VladVeliciu/Automatic-Greenhouse-System/Bill of Materials.PDF

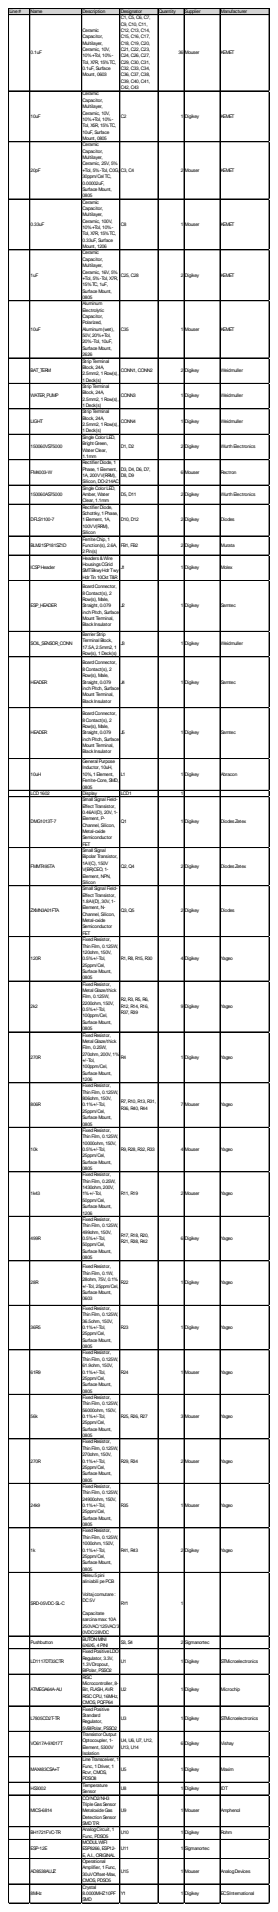
[picture p1: page 1]

10uF | Ceramic Capacitor, Multilayer, Ceramic, 10V, 10%+Tol, 10%-Tol, X5R, 15%TC, 10uF, Surface Mount, 0805 | C2 | 1 Digikey | KEMET

20pF | Ceramic Capacitor, Multilayer, Ceramic, 25V, 5% +Tol, 5%-Tol, C0G, 30ppm/Cel TC, 0.00002uF, Surface Mount, 0805 | C3, C4 | 2 Mouser | KEMET

0.33uF | Ceramic Capacitor, Multilayer, Ceramic, 100V, 10%+Tol, 10%-Tol, X7R, 15%TC, 0.33uF, Surface Mount, 1206 | C8 | 1 Mouser | KEMET

1uF | Ceramic Capacitor, Multilayer, Ceramic, 16V, 5% +Tol, 5%-Tol, X7R, 15%TC, 1uF, Surface Mount, 0805 | C25, C28 | 2 Digikey | KEMET

10uF | Aluminum Electrolytic Capacitor, Polarized, Aluminum(wet), 50V, 20%+Tol, 20%-Tol, 10uF, Surface Mount, 2626 | C35 | 1 Mouser | KEMET

BAT_TERM | Strip Terminal Block, 24A, 2.5mm2, 1Row(s), 1Deck(s) | CONN1, CONN2 | 2 Digikey | Weidmuller

WATER_PUMP | Strip Terminal Block, 24A, 2.5mm2, 1Row(s), 1Deck(s) | CONN3 | 1 Digikey | Weidmuller

LIGHT | Strip Terminal Block, 24A, 2.5mm2, 1Row(s), 1Deck(s) | CONN4 | 1 Digikey | Weidmuller

150060VS75000 | Single Color LED, Bright Green, Water Clear, 1.1mm | D1, D2 | 2 Digikey | WurthElectronics

FM4003-W | Rectifier Diode, 1 Phase, 1Element, 1A, 200VV(RRM), Silicon, DO-214AC | D3, D4, D6, D7, D8, D9 | 6 Mouser | Rectron

150060AS75000 | Single Color LED, Amber, Water Clear, 1.1mm | D5, D11 | 2 Digikey | WurthElectronics

DFLS1100-7 | Rectifier Diode, Schottky, 1Phase, 1Element, 1A, 100VV(RRM), Silicon | D10, D12 | 2 Digikey | Diodes

BLM21SP181SZ1D | FerriteChip, 1 Function(s), 2.6A, 2Pin(s) | FB1, FB2 | 2 Digikey | Murata

ICSPHeader | Headers&Wire HousingsCGrid SMTBkwyHdr Twy Hdr Tin 10Ckt T&R | J1 | 1 Digikey | Molex

ESP_HEADER | BoardConnector, 8Contact(s), 2 Row(s), Male, Straight, 0.079 inchPitch, Surface Mount Terminal, Black Insulator | J2 | 1 Digikey | Samtec

SOIL_SENSOR_CONN | Barrier Strip Terminal Block, 17.5A, 2.5mm2, 1 Row(s), 1Deck(s) | J3 | 1 Digikey | Weidmuller

HEADER | BoardConnector, 8Contact(s), 2 Row(s), Male, Straight, 0.079 inchPitch, Surface Mount Terminal, Black Insulator | J4 | 1 Digikey | Samtec

HEADER | BoardConnector, 8Contact(s), 2 Row(s), Male, Straight, 0.079 inchPitch, Surface Mount Terminal, Black Insulator | J5 | 1 Digikey | Samtec

10uH | General Purpose Inductor, 10uH, 10%, 1Element, Ferrite-Core, SMD, 0805 | L1 | 1 Digikey | Abracon

LCD1602 | Display | LCD1 | 1
DMG1013T-7 | Small Signal Field-Effect Transistor, 0.46AI(D), 20V, 1-Element, P-Channel, Silicon, Metal-oxide Semiconductor FET | Q1 | 1 Digikey | DiodesZetex

FMMT495TA | Small Signal Bipolar Transistor, 1AI(C), 150V V(BR)CEO, 1-Element, NPN, Silicon | Q2, Q4 | 2 Digikey | DiodesZetex

ZXMN3A01FTA | Small Signal Field-Effect Transistor, 1.8AI(D), 30V, 1-Element, N-Channel, Silicon, Metal-oxide Semiconductor FET | Q3, Q5 | 2 Digikey | Diodes

120R | FixedResistor, Thin Film, 0.125W, 120ohm, 150V, 0.5%+/-Tol, 25ppm/Cel, Surface Mount, 0805 | R1, R8, R15, R30 | 4 Digikey | Yageo

2k2 | FixedResistor, Metal Glaze/thick Film, 0.125W, 2200ohm, 150V, 0.5%+/-Tol, 100ppm/Cel, Surface Mount, 0805 | R2, R3, R5, R6, R12, R14, R16, R37, R39 | 9 Digikey | Yageo

270R | FixedResistor, Metal Glaze/thick Film, 0.25W, 270ohm, 200V, 1% +/-Tol, 100ppm/Cel, Surface Mount, 1206 | R4 | 1 Digikey | Yageo

806R | FixedResistor, Thin Film, 0.125W, 806ohm, 150V, 0.1%+/-Tol, 25ppm/Cel, Surface Mount, 0805 | R7, R10, R13, R31, R36, R40, R44 | 7 Mouser | Yageo

10k | FixedResistor, Thin Film, 0.125W, 10000ohm, 150V, 0.5%+/-Tol, 25ppm/Cel, Surface Mount, 0805 | R9, R28, R32, R33 | 4 Mouser | Yageo

1k43 | FixedResistor, Thin Film, 0.25W, 1430ohm, 200V, 1%+/-Tol, 50ppm/Cel, Surface Mount, 1206 | R11, R19 | 2 Mouser | Yageo

499R | FixedResistor, Thin Film, 0.125W, 499ohm, 150V, 0.5%+/-Tol, 50ppm/Cel, Surface Mount, 0805 | R17, R18, R20, R21, R38, R42 | 6 Digikey | Yageo

28R | FixedResistor, Thin Film, 0.1W, 28ohm, 75V, 0.1% +/-Tol, 25ppm/Cel, Surface Mount, 0603 | R22 | 1 Digikey | Yageo

36R5 | FixedResistor, Thin Film, 0.125W, 36.5ohm, 150V, 0.1%+/-Tol, 25ppm/Cel, Surface Mount, 0805 | R23 | 1 Digikey | Yageo

61R9 | FixedResistor, Thin Film, 0.125W, 61.9ohm, 150V, 0.1%+/-Tol, 25ppm/Cel, Surface Mount, 0805 | R24 | 1 Mouser | Yageo

56k | FixedResistor, Thin Film, 0.125W, 56000ohm, 150V, 0.1%+/-Tol, 25ppm/Cel, Surface Mount, 0805 | R25, R26, R27 | 3 Mouser | Yageo

270R | FixedResistor, Thin Film, 0.125W, 270ohm, 150V, 0.1%+/-Tol, 25ppm/Cel, Surface Mount, 0805 | R29, R34 | 2 Mouser | Yageo

24k9 | FixedResistor, Thin Film, 0.125W, 24900ohm, 150V, 0.1%+/-Tol, 25ppm/Cel, Surface Mount, 0805 | R35 | 1 Mouser | Yageo

1k | FixedResistor, Thin Film, 0.125W, 1000ohm, 150V, 0.1%+/-Tol, 25ppm/Cel, Surface Mount, 0805 | R41, R43 | 2 Digikey | Yageo

SRD-05VDC-SL-C | Releu5pini aliniabili pePCB Voltaj comutare: DC5V Capacitate sarcinamax: 10A 250VAC/125VAC/3 0VDC/28VDC | RY1 | 1

Pushbutton | BUTONMINI 6X6X5, 4PINI | S3, S4 | 2 Sigmanortec

LD1117DT33CTR | FixedPositiveLDO Regulator, 3.3V, 1.3VDropout, BIPolar, PSSO2 | U1 | 1 Digikey | STMicroelectronics

ATMEGA64A-AU | RISC Microcontroller, 8-Bit, FLASH, AVR RISCCPU, 16MHz, CMOS, PQFP64 | U2 | 1 Digikey | Microchip

L7805CD2T-TR | FixedPositive Standard Regulator, 5VBIPolar, PSSO2 | U3 | 1 Digikey | STMicroelectronics

VO617A-9X017T | Transistor Output Optocoupler, 1-Element, 5300V Isolation | U4, U6, U7, U12, U13, U14 | 6 Digikey | Vishay

MAX483CSA+T | LineTransceiver, 1 Func, 1Driver, 1 Rcvr, CMOS, PDSO8 | U5 | 1 Digikey | Maxim

HS3002 | Temperature Sensor | U8 | 1 Digikey | IDT

MICS-6814 | CO/NO2/NH3 Triple GasSensor MetaloxideGas DetectionSensor SMDT/R | U9 | 1 Mouser | Amphenol

BH1721FVC-TR | AnalogCircuit, 1 Func, PDSO5 | U10 | 1 Digikey | Rohm

ESP-12E | MODULWIFI ESP8266, ESP12-E, A.I., ORIGINAL | U11 | 1 Sigmanortec

AD8538AUJZ | Operational Amplifier, 1Func, 30uVOffset-Max, CMOS, PDSO5 | U15 | 1 Mouser | AnalogDevices

8MHz | Crystal 8.0000MHZ10PF SMD | Y1 | 1 Digikey | ECSInternational
