VladVeliciu/Automatic-Greenhouse-System/Schematic Prints.PDF

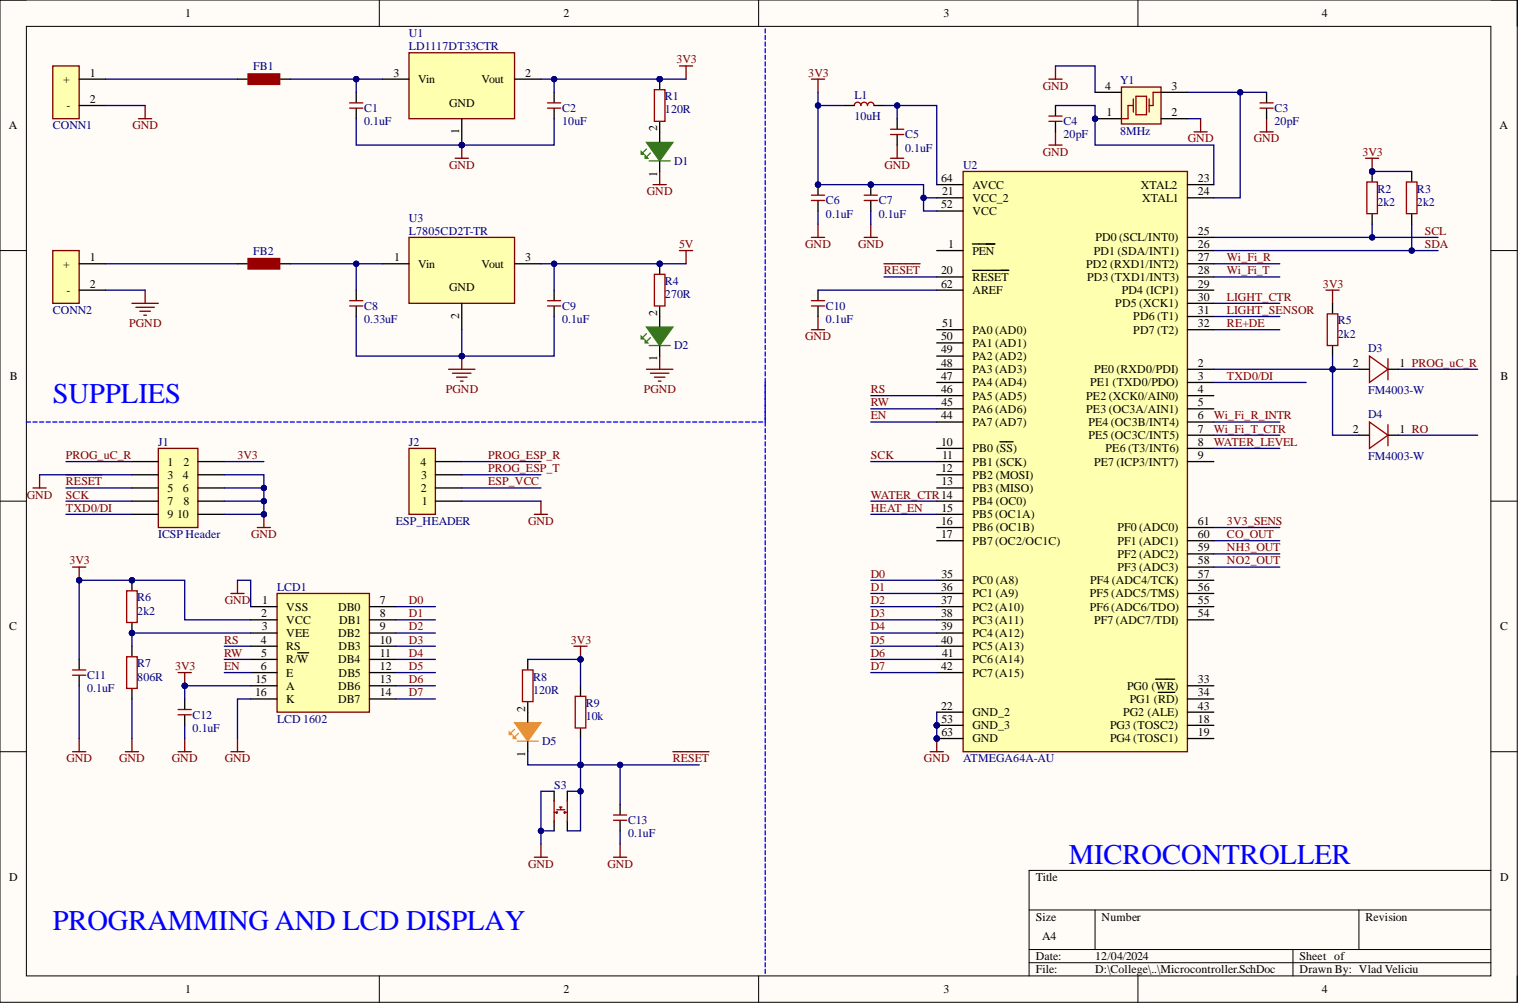
[picture p2: page 1]

PROGRAMMING AND LCD DISPLA

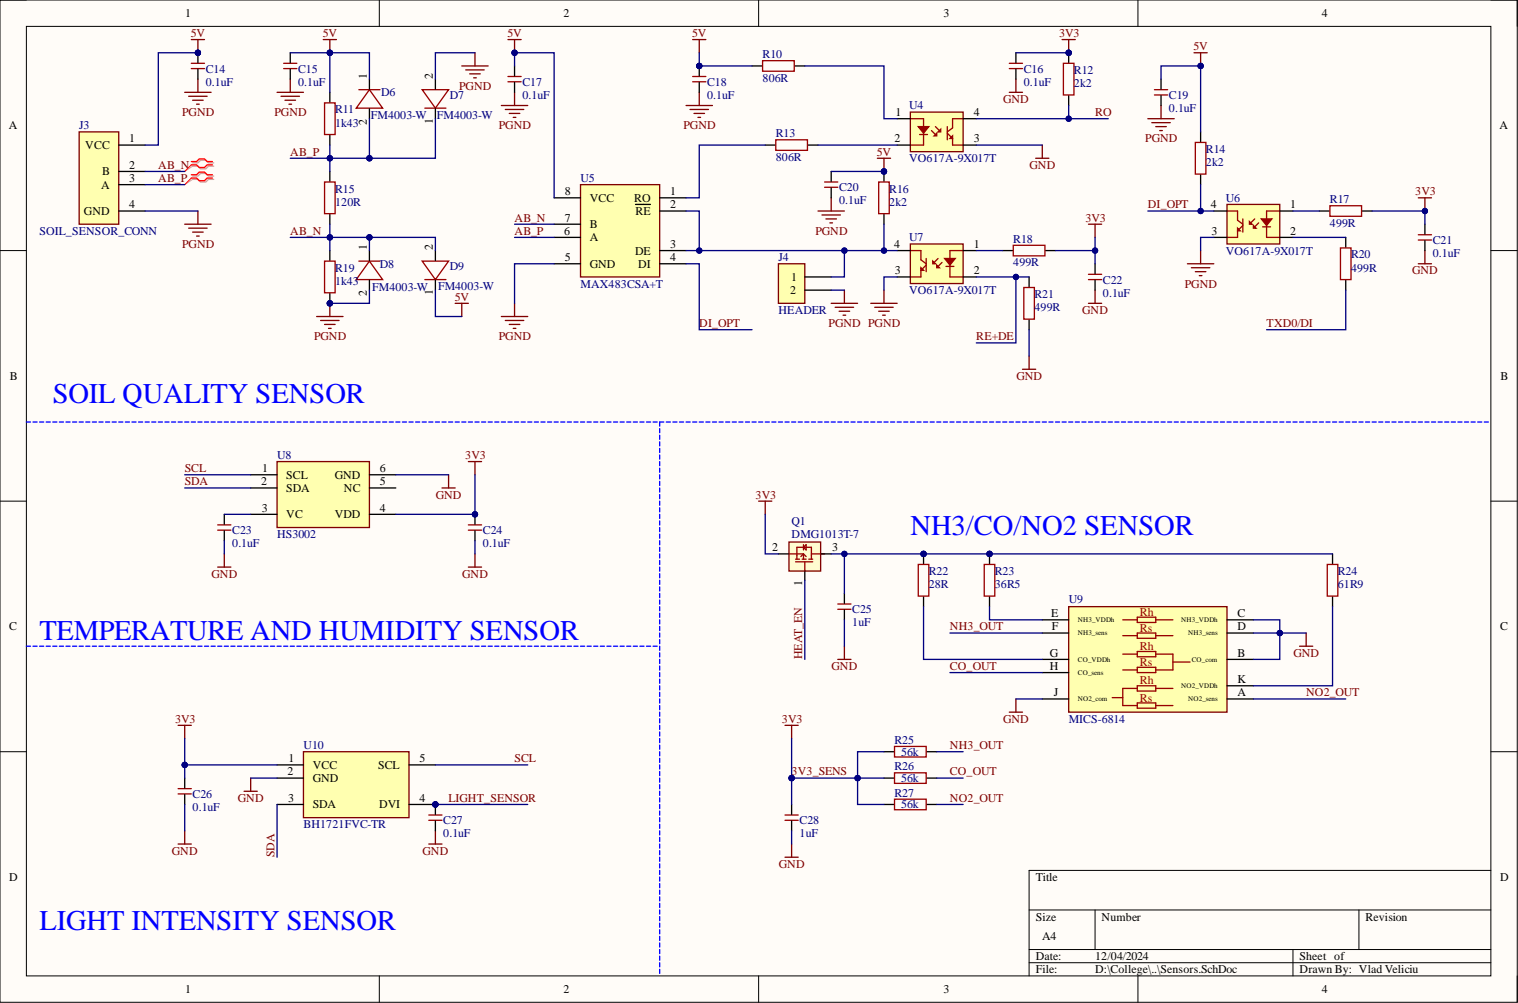
[picture p3: page 2]

TEMPERATURE AND HUMIDITY SENSOR

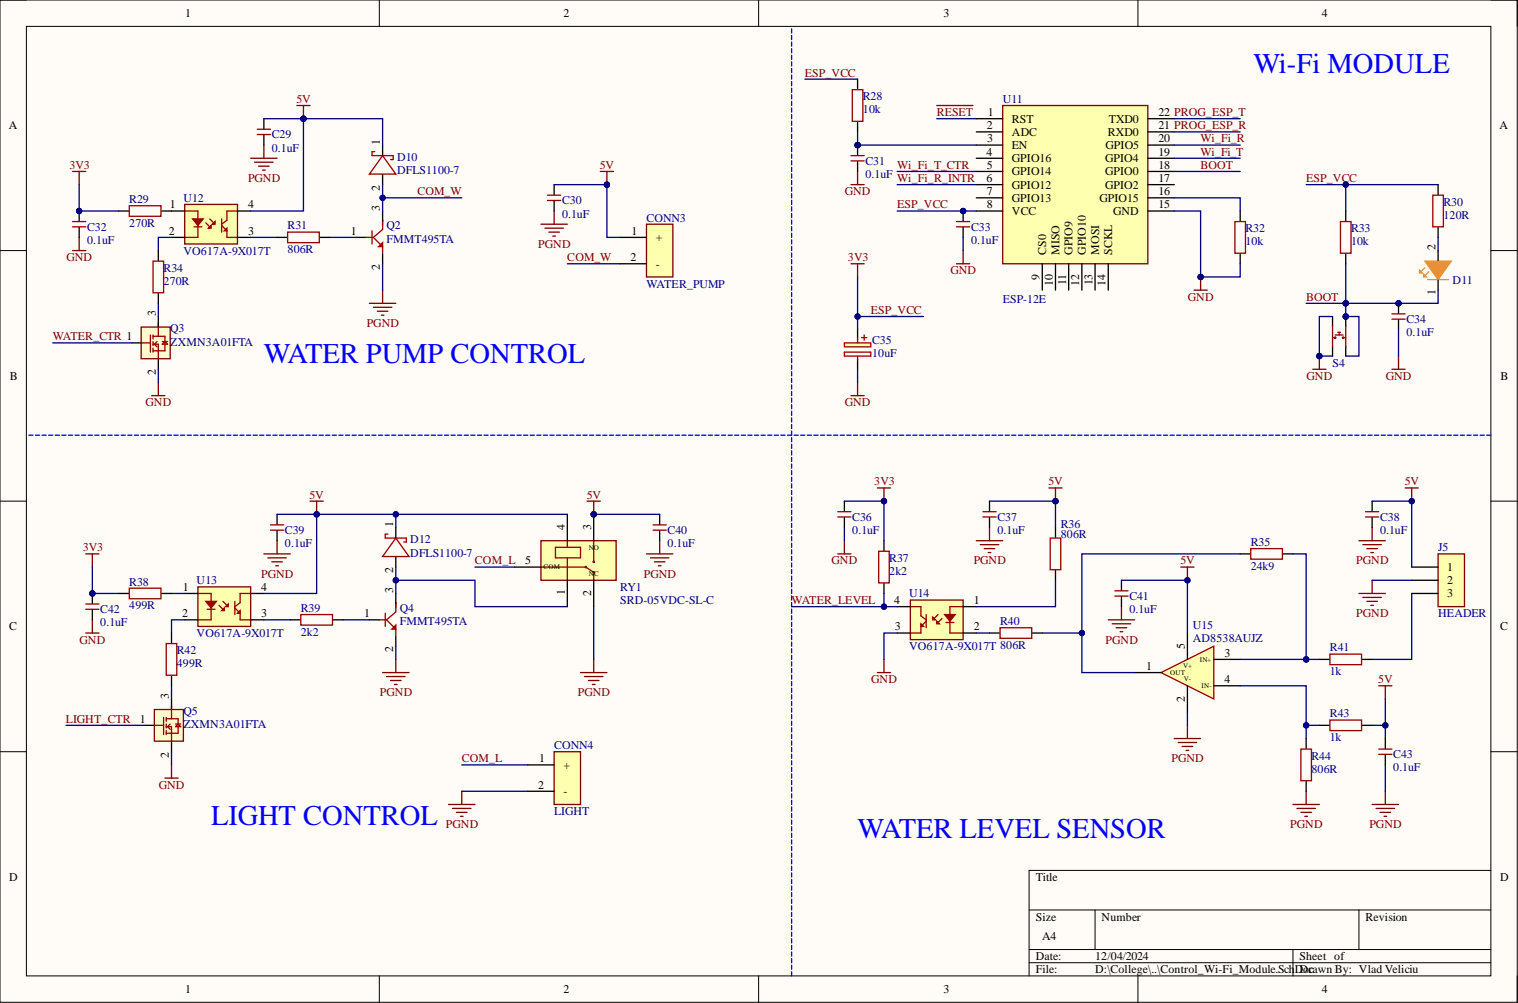
[picture p4: page 3]
