VladVeliciu/Automatic-Greenhouse-System/(list of files, drawings)

Other design files:
Bachelor.pdsprj
